hhitmann/Air-Quality-Monitoring-System-AQMS-Project/Tables/Evaluation_CO2_Temperature_Humidity_IAQI.jpeg

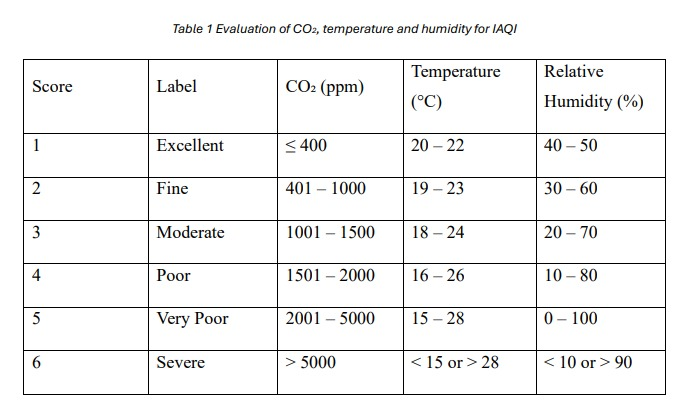
Tables/Evaluation_CO2_Temperature_Humidity_IAQI.jpeg
