hhitmann/Air-Quality-Monitoring-System-AQMS-Project/ESP32_Firmware/config.example.h

// config.example.h
// Copy this file to config.h and fill in your own credentials.
// NEVER upload config.h to GitHub!

const char* WIFI_SSID_1 = "YOUR_WIFI_SSID_HERE";
const char* WIFI_PASS_1 = "YOUR_WIFI_PASSWORD_HERE";
const char* WIFI_SSID_2 = "SECONDARY_WIFI_SSID";
const char* WIFI_PASS_2 = "SECONDARY_WIFI_PASSWORD";

const char* discord_webhook = "YOUR_DISCORD_WEBHOOK_URL_HERE";

#define DATABASE_URL "YOUR_FIREBASE_PROJECT_URL_HERE"
#define DATABASE_SECRET "YOUR_FIREBASE_DATABASE_SECRET_HERE"
